Xevel/usb2ax/pc_software/usb2ax_updater/usb2ax_updater.jpg

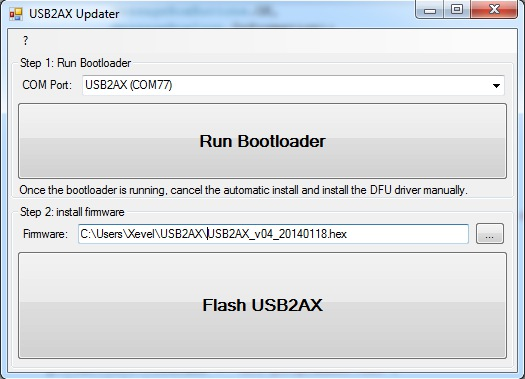
pc_software/usb2ax_updater/usb2ax_updater.jpg
