Xevel/usb2ax/(threads)

Thread 1 (2016-09-08):

Can send use a sync_write

metropt, 2016-09-08:
I'm trying to write the goal pos to two motors however I need to send the following packet two times to make it work whatever id I choose first only the first motor on the chain is activated :sa:

```
            dxl_set_txpacket_id( 254 );
            dxl_set_txpacket_length( 10 ); //Length (L+1) X N + 4   (L: Data Length per RX-64, N: the number of RX-64s)
            dxl_set_txpacket_instruction( 131 );
            dxl_set_txpacket_parameter( 0, GOAL_POSITION_L );
            dxl_set_txpacket_parameter( 1, 2 );
            dxl_set_txpacket_parameter( 2, 2 );
            dxl_set_txpacket_parameter( 3, dxl_get_lowbyte( goal_pos_[0] ) );
            dxl_set_txpacket_parameter( 4, dxl_get_highbyte( goal_pos_[0] ) );
            dxl_set_txpacket_parameter( 5, 1 );
            dxl_set_txpacket_parameter( 6, dxl_get_lowbyte( goal_pos_[0] ) );
            dxl_set_txpacket_parameter( 7, dxl_get_highbyte( goal_pos_[0] ) );
```

Xevel, 2016-09-08:
Hi!
I'm not really sure what is going wrong here, are you sure the rest of the setup is OK?
Can you move the second servo with a write_data packet?

And also, if you are using the version of the lib I have on this repo, why don't you simply use the sync_write functions instead of building the packet yourself (less error-prone)?
[Sync_read example that also shows the sync_write](https://github.com/Xevel/usb2ax/blob/master/pc_software/usb2ax_DynamixelSDK/DynamixelSDK_sync/example/win32/visual%20c%2B%2B/SyncRead/SyncRead.cpp)

metropt, 2016-09-13:
Hello,

I tried the sync_write from you lib and it works well however now I'm getting problems with sync_read. I got a lot incorrect status packet:

`[ INFO] [1473761250.694434838]: 1=559
[ INFO] [1473761250.694477383]: 2=300

[ INFO] [1473761250.714561671]: 1=559
[ INFO] [1473761250.714606049]: 2=300

[ INFO] [1473761250.734441294]: 1=559
[ INFO] [1473761250.734487448]: 2=300

[ INFO] [1473761250.754562067]: 1=559
[ INFO] [1473761250.754605699]: 2=300

[ INFO] [1473761250.774435077]: 1=559
[ INFO] [1473761250.774478255]: 2=300

[ INFO] [1473761250.794558795]: 1=559
[ INFO] [1473761250.794600594]: 2=300

[ INFO] [1473761250.814441386]: 1=559
[ INFO] [1473761250.814486643]: 2=300

[ INFO] [1473761250.834686948]: 1=559
[ INFO] [1473761250.834731101]: 2=300

[ INFO] [1473761250.854559114]: 1=559
[ INFO] [1473761250.854600383]: 2=300

[ INFO] [1473761250.874564379]: 1=559
[ INFO] [1473761250.874611105]: 2=300

[ INFO] [1473761250.894564307]: 1=559
[ INFO] [1473761250.894609096]: 2=300

[ INFO] [1473761250.914686532]: 1=559
[ INFO] [1473761250.914726632]: 2=300

[ INFO] [1473761250.934559446]: 1=559
[ INFO] [1473761250.934602664]: 2=300

[ INFO] [1473761250.954562389]: 1=559
[ INFO] [1473761250.954605527]: 2=300

[ INFO] [1473761250.974561927]: 1=559
[ INFO] [1473761250.974605576]: 2=300

[ INFO] [1473761250.994559181]: 1=559
[ INFO] [1473761250.994600444]: 2=300

[ INFO] [1473761251.014439385]: 1=559
[ INFO] [1473761251.014485850]: 2=300

[ INFO] [1473761251.034558490]: 1=559
[ INFO] [1473761251.034600241]: 2=300

[ INFO] [1473761251.054563809]: 1=559
[ INFO] [1473761251.054608194]: 2=300

[ INFO] [1473761251.074564510]: 1=559
[ INFO] [1473761251.074611699]: 2=300

[ INFO] [1473761251.094436413]: 1=559
[ INFO] [1473761251.094479037]: 2=300

[ INFO] [1473761251.114559450]: 1=559
[ INFO] [1473761251.114601346]: 2=300

[ INFO] [1473761251.134558628]: 1=559
[ INFO] [1473761251.134599705]: 2=300

[ INFO] [1473761251.154616545]: 1=559
[ INFO] [1473761251.154661347]: 2=300

[ INFO] [1473761251.174593964]: 1=559
[ INFO] [1473761251.174654738]: 2=300

[ INFO] [1473761251.194599484]: 1=559
[ INFO] [1473761251.194650821]: 2=300

[ INFO] [1473761251.214469942]: 1=559
[ INFO] [1473761251.214513722]: 2=300

[ INFO] [1473761251.234599732]: 1=559
[ INFO] [1473761251.234645621]: 2=300

[ INFO] [1473761251.254598864]: 1=559
[ INFO] [1473761251.254644714]: 2=300

[ INFO] [1473761251.274591423]: 1=559
[ INFO] [1473761251.274632121]: 2=300

[ INFO] [1473761251.294593208]: 1=559
[ INFO] [1473761251.294635295]: 2=300

[ INFO] [1473761251.314467278]: 1=559
[ INFO] [1473761251.314507783]: 2=65535

[ INFO] [1473761251.334477456]: 1=559
[ INFO] [1473761251.334546297]: 2=300

[ INFO] [1473761251.354603917]: 1=559
[ INFO] [1473761251.354650028]: 2=65535

[ INFO] [1473761251.374588057]: 1=559
[ INFO] [1473761251.374633864]: 2=300

[ INFO] [1473761251.394576031]: 1=559
[ INFO] [1473761251.394620455]: 2=300

[ INFO] [1473761251.414601759]: 1=559
[ INFO] [1473761251.414647350]: 2=300

[ INFO] [1473761251.434592444]: 1=559
[ INFO] [1473761251.434632395]: 2=65535

[ INFO] [1473761251.454596015]: 1=559
[ INFO] [1473761251.454638298]: 2=300

[ INFO] [1473761251.474575276]: 1=559
[ INFO] [1473761251.474634469]: 2=65535

[ INFO] [1473761251.494566517]: 1=559
[ INFO] [1473761251.494618563]: 2=300

[ INFO] [1473761251.514566383]: 1=559
[ INFO] [1473761251.514618284]: 2=65535

[ INFO] [1473761251.534442431]: 1=559
[ INFO] [1473761251.534496357]: 2=301

[ INFO] [1473761251.554566425]: 1=559
[ INFO] [1473761251.554617983]: 2=65535

[ INFO] [1473761251.574567989]: 1=559
[ INFO] [1473761251.574622302]: 2=300

[ INFO] [1473761251.594581237]: 1=559
[ INFO] [1473761251.594637699]: 2=65535

[ INFO] [1473761251.614568112]: 1=559
[ INFO] [1473761251.614619575]: 2=300

[ INFO] [1473761251.634567871]: 1=559
[ INFO] [1473761251.634619959]: 2=65535

[ INFO] [1473761251.654570137]: 1=559
[ INFO] [1473761251.654623414]: 2=300

[ INFO] [1473761251.674563754]: 1=559
[ INFO] [1473761251.674613520]: 2=65535

[ INFO] [1473761251.694447221]: 1=559
[ INFO] [1473761251.694503734]: 2=300

[ INFO] [1473761251.714566023]: 1=559
[ INFO] [1473761251.714616845]: 2=65535

COMM_RXCORRUPT: Incorrect status packet!

[ INFO] [1473761251.754587500]: 1=559
[ INFO] [1473761251.754662450]: 2=65535

COMM_RXCORRUPT: Incorrect status packet!

[ INFO] [1473761251.794586438]: 1=559
[ INFO] [1473761251.794654394]: 2=65535

^CCOMM_RXCORRUPT: Incorrect status packet!

[ INFO] [1473761251.834603526]: 1=559
[ INFO] [1473761251.834656415]: 2=65535

COMM_RXCORRUPT: Incorrect status packet!

[wiigo_active_camera-1] killing on exit
[ INFO] [1473761251.874591459]: 1=559
[ INFO] [1473761251.874650561]: 2=300

COMM_RXCORRUPT: Incorrect status packet!
`

Any idea?

My setup:
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

Xevel, 2016-09-13:
Hmm, not sure, but have you set Reponse Delay to zero on all servos? the timeout in the sync_read code is pretty short, could have something to do with it...

Thread 4 (2017-07-26):

Handle dynamixel protocol 2 ...

tho-, 2017-07-26:
Hi,

I flashed the latest firmware available in the repo ( USB2AX_v05RC0.hex ) on a USB2AX v3.2a.
I'm communicating with MX and XM motors that talk protocol 2.

The problem is that all messages, that start by construction with 0xff 0xff 0xfd 0x0, are interpreted by the USB2AX as (bad) messages for itself with a 0 length. So it passes the message to the MX motor (ok), but then replies on the usb with a protocol 1 error message which does not make sense here.

Would there be a way to disable this interpretation of dynamixel protocol? Or recognize protol 2 messages (starting with 0xff ff fd 00) as such and not reply with an error?

Xevel, 2017-07-26:
Hi,

Could you put the old (v04) firmware back please?
I'll need some time to get to this, can't do it right away.

You cab download it here: http://www.xevelabs.com/doku.php?id=product:usb2ax:firmware

Best
Nicolas

tho-, 2017-07-26:
On Wednesday 26 Jul 2017, at 18:32, Nicolas SAUGNIER wrote:
> Could you put the old (v04) firmware back please?
> I'll need some time to get to this, can't do it right away.

No, the old firmware is not usable for me. I need to transmit large
messages, (around 128 bytes x 2 motors or even 3), and I had a lot of
message corruption with the v04 firmware. (while the exact same setup
runs fine with the USBtoDynamixel device).

That's why I upgraded. The increased buffer size in the latest version
helps a lot. (although I still experience a few message corruption
from time to time).

I understand perfectly that you cannot work on this immediately.
The short-term fix I have in mind is just a couple of lines long. If I
suggest a patch, maybe you could just apply it and build a new image
in a few minutes?

I wish I could compile the code myself. But when I tried, I could not
produce a useable software. I don't have AVR Studio, so I compiled
everything manually with avr-gcc (on linux), but for some reason the
hex file I obtain is about ~40kB large (instead of the ~17kB file in
the repository) and hangs the device when it is flashed. I tried to
put the same avr-gcc options as in the .cproj file (-Os, -gc-sections,
etc.), but I could not understand why it's not working yet.

Xevel, 2017-07-26:
Hmm, seems like there is definitely a big problem on my side, sorry about that.

If you have a fix I can compile it for you, sure.

For your problem with avr-gcc, seems to me like link-time issues, where some "standard" libs are automatically added by AVR studio.

Just out of curiosity, what is your application where you need to send messages that long - it you can share ?

tho-, 2017-07-26:
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

I attach a diff which should do the trick. (untested, however).
Comments in the code should explain what I'm doing, but if you have
any doubt we can discuss about it.

> For your problem with avr-gcc, seems to me like link-time issues,
> where some "standard" libs are automatically added by AVR studio.

If AVR studio ever displays the actual compile command line, I'd be
curious to compare with what I'm doing.

> Just out of curiosity, what is your application where you need to
> send messages that long - it you can share ?

To be exact, I need to receive such messages, not to send them. When
configuring the motors, I use a protocol 2.0 SYNC_READ message to
retrieve a great part of the control table of all connected devices.

It's true that I could split this into several smaller messages. It's
doable if nothing else works, but since I saw the commits here, fixing
the buffer issue, I wanted to give it a try first (and I was not sure
until after trying that the message size was the issue).

The other issue that I'm trying to address in the attached patch seems
to be only remaining one, so I'd say it's worth trying to get rid of
it :) But if you think that v04 would work better with small
protocol 2.0 messages, then I could try to do that instead.

My code is freely available, although of little interest to share
because it uses a custom integration framework (also free, but complex
to get into). All this is part of research projects using multirotor
drones equipped with manipulator arms.
You can get an idea there:
http://homepages.laas.fr/afranchi/robotics/?q=node/416
The actual motor code can be seen here:
https://git.openrobots.org/projects/dynamixel-genom3/repository

diff --git firmware/lufa_usb2ax/USB2AX.c firmware/lufa_usb2ax/USB2AX.c
index 8692398..22f8e40 100644
--- firmware/lufa_usb2ax/USB2AX.c
+++ firmware/lufa_usb2ax/USB2AX.c
@@ -293,8 +293,13 @@ void process_incoming_USB_data(void){
                    
                 case AX_SEARCH_LENGTH:
                     rxbyte[rxbyte_count++] = CDC_Device_ReceiveByte(&USB2AX_CDC_Interface);
-                    if (rxbyte[PACKET_ID] == AX_ID_DEVICE || rxbyte[PACKET_ID] == AX_ID_BROADCAST ){
-                        if (rxbyte[PACKET_LENGTH] > 1 && rxbyte[PACKET_LENGTH] < (AX_SYNC_READ_MAX_DEVICES + 4)){  // reject message if too short or too big for rxbyte buffer
+                    if (rxbyte[PACKET_ID] == 0xFD && (rxbyte[PACKET_LENGTH] == 0 || rxbyte[PACKET_LENGTH] == 0xFD)) {
+                        // We've seen 0xFF 0xFF 0xFD 0x0 or 0xFF 0xFF 0xFD 0xFD
+                        // Both are protocol 2.0 messages (header or "byte stuffing")
+                        // Let this pass - both are invalid for us anyway
+                        cleanup_input_parser();
+                    } else if (rxbyte[PACKET_ID] == AX_ID_DEVICE || rxbyte[PACKET_ID] == AX_ID_BROADCAST ){
+                         if (rxbyte[PACKET_LENGTH] > 1 && rxbyte[PACKET_LENGTH] < (AX_SYNC_READ_MAX_DEVICES + 4)){  // reject message if too short or too big for rxbyte buffer
                             ax_state = AX_SEARCH_COMMAND;
                             receive_timer = 0;
                         } else {

Xevel, 2017-07-27:
Hi,

So I had a better look... and sure enough stuff is all f**** up when using DXL2.0 with the latest version of Dynamixel Wizard, and I guess the fact that it worked in other cases was just down to implementation details (a lib that would match 1-1 packets would never receive the answer to sync_read_2.0, whereas one that processes packet as they come might...).

So I applied your patch, and things look better now.
I uploaded the binary of v05 RC1, please tell me if it fixed your problem.
Also so far I credited you with your github handle, let me know if you prefer your real name.

Find here the full output of the build : https://pastebin.com/QhbBByLH

And that's pretty cool stuff you're working on :D Have fun!

tho-, 2017-07-27:
On Wednesday 26 Jul 2017, at 22:47, Nicolas SAUGNIER wrote:
> So I applied your patch, and things look better now.  I uploaded the
> binary of v05 RC1, please tell me if it fixed your problem.

Yes. I just did a quick test, but it already shows much better
results.
Thanks Nicolas for the promptness!

> Also so far I credited you with your github handle, let me know if
> you prefer your real name.

I'm Anthony Mallet outside github, which might be a more reliable
name than my github handle :) But don't bother with this, I don't care
so much :)

> Find here the full output of the build :
> https://pastebin.com/QhbBByLH

Thanks, I will check. If I later manage to build it for linux, I might
submit a Makefile or something, to add in the repo, if you like.

Closed 2017-07-27.
