Xevel/usb2ax/hardware/usb2ax_v3.2.brd

## EAGLE design hardware/usb2ax_v3.2.brd (2016-04-06, an earlier design)

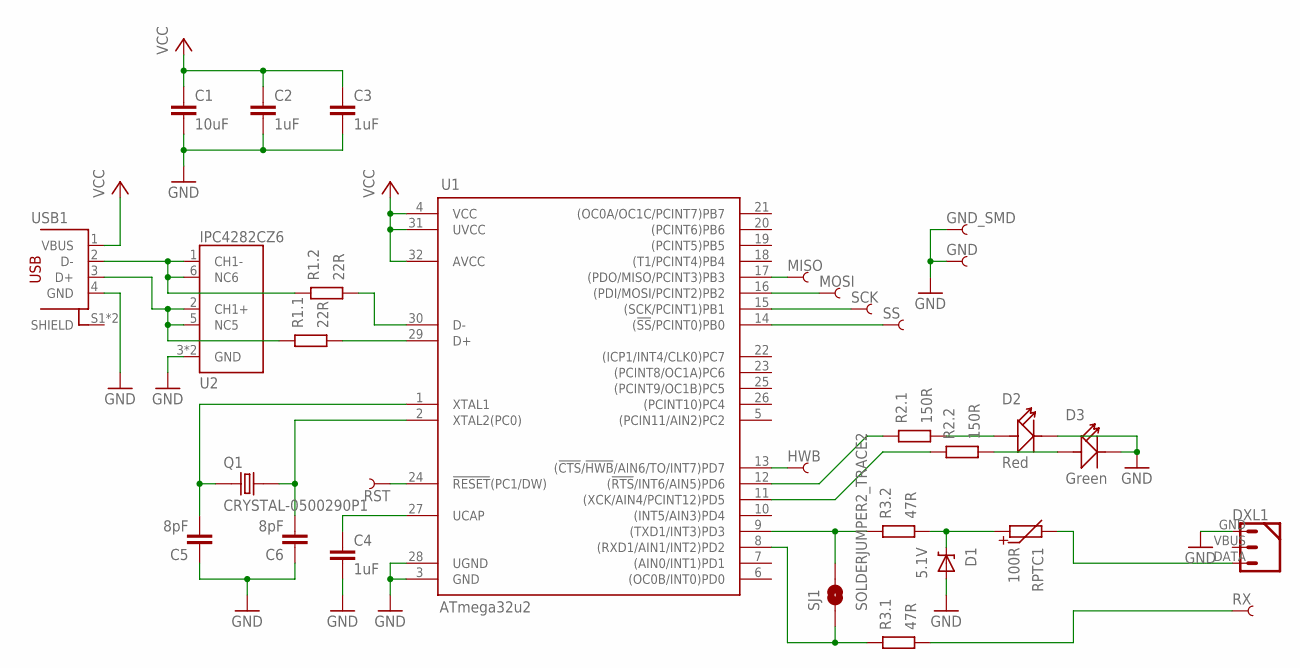
[picture p2: schematic usb2ax_v3.2.sch]

Parts:
C1: 10uF; 0805_L
C2, C3, C4: 1uF; 0402_N
C5, C6: 8pF; 0402_N
D1: 5.1V; SOD-923_N
D2: Red; LED0603
D3: Green; LED0603
DXL1: DYNAMIXEL_3POS; DYMANIXEL_3POS_RIGHT
GND: PIN_SMD_2X2.5
GND_SMD: PIN_SMD_2X2.5
HWB: PIN_SMD_2X2.5
MISO: PIN_SMD_2X2.5
MOSI: PIN_SMD_2X2.5
Q1: CRYSTAL-0500290P1; 2P-SMD-5.0X3.2
R1: 22R; ARRAY_0402_65P_2_N
R2: 150R; ARRAY_0402_65P_2_N
R3: 47R; ARRAY_0402_65P_2_N
RPTC1: 100R; 0603_N
RST: PIN_SMD_2X2.5
RX: PIN_THT_0.8; PIN_0.8
SCK: PIN_SMD_2X2.5
SJ1: SOLDERJUMPER2_TRACE2; SJ_2S-TRACE2
SS: PIN_SMD_2X2.5
U1: ATmega32u2; QFN-32_50P_L_MOD
U2: IPC4282CZ6; XSON6_N
USB1: USB-STANDARD-PLUG_A_THT; USB-A-THT

Connections:
GND: C1.2, C2.2, C3.2, C4.2, C5.1, C6.1, D1.A, D2.-, D3.-, DXL1.GND (1), GND.PIN, GND_SMD.PIN, U1.3 (GND), U1.28 (UGND), U2.3 (GND), U2.4 (GND), USB1.4 (GND)
HWB: HWB.PIN, U1.13 ((!CTS!/!HWB!/AIN6/TO/INT7)PD7)
unnamed: R3.4 (2), SJ1.2, U1.9 ((TXD1/INT3)PD3)
unnamed: R3.3 (2), SJ1.1, U1.8 ((RXD1/AIN1/INT2)PD2)
unnamed: C4.1, U1.27 (UCAP)
unnamed: D1.C, R3.1, RPTC1.1
unnamed: R2.4 (2), U1.11 ((XCK/AIN4/PCINT12)PD5)
unnamed: DXL1.DATA (3), RPTC1.2
unnamed: C6.2, Q1.2, U1.2 (XTAL2(PC0))
unnamed: C5.2, Q1.1, U1.1 (XTAL1)
unnamed: R1.1, U1.30 (D-)
unnamed: R1.2 (1), U1.29 (D+)
unnamed: R1.4 (2), U2.1 (CH1-), U2.6 (NC6), USB1.2 (D-)
unnamed: R1.3 (2), U2.2 (CH1+), U2.5 (NC5), USB1.3 (D+)
unnamed: D2.+, R2.2 (1)
unnamed: D3.+, R2.1
unnamed: R2.3 (2), U1.12 ((!RTS!/INT6/AIN5)PD6)
unnamed: R3.2 (1), RX.PIN
unnamed: MISO.PIN, U1.17 ((PDO/MISO/PCINT3)PB3)
unnamed: MOSI.PIN, U1.16 ((PDI/MOSI/PCINT2)PB2)
unnamed: SCK.PIN, U1.15 ((SCK/PCINT1)PB1)
unnamed: SS.PIN, U1.14 ((!SS!/PCINT0)PB0)
RST: RST.PIN, U1.24 (!RESET!(PC1/DW))
VCC: C1.1, C2.1, C3.1, U1.4 (VCC), U1.31 (UVCC), U1.32 (AVCC), USB1.1 (VBUS)

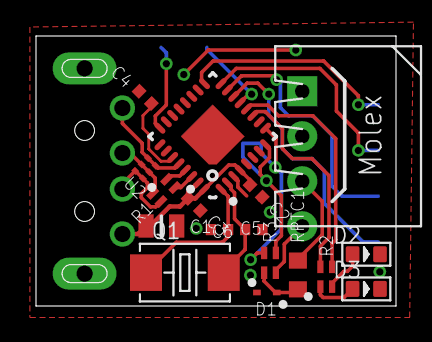
[picture p3: board usb2ax_v3.2.brd from above]

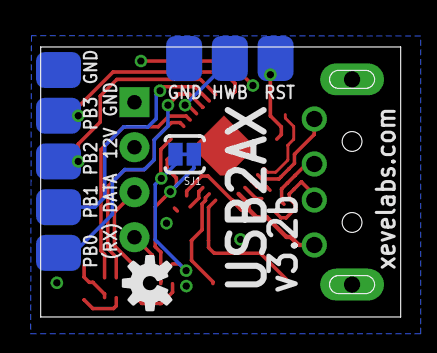
[picture p4: board usb2ax_v3.2.brd from below]

Board: 2 copper layers, 20.0 x 15.0 mm, 29 parts (10 on the bottom side), 24 nets.

Other parts of the board:
U$1: OSHW-LOGO-S
