Xevel/usb2ax/hardware/usb2ax_v4.0.brd

## EAGLE design hardware/usb2ax_v4.0.brd (2014-12-30)

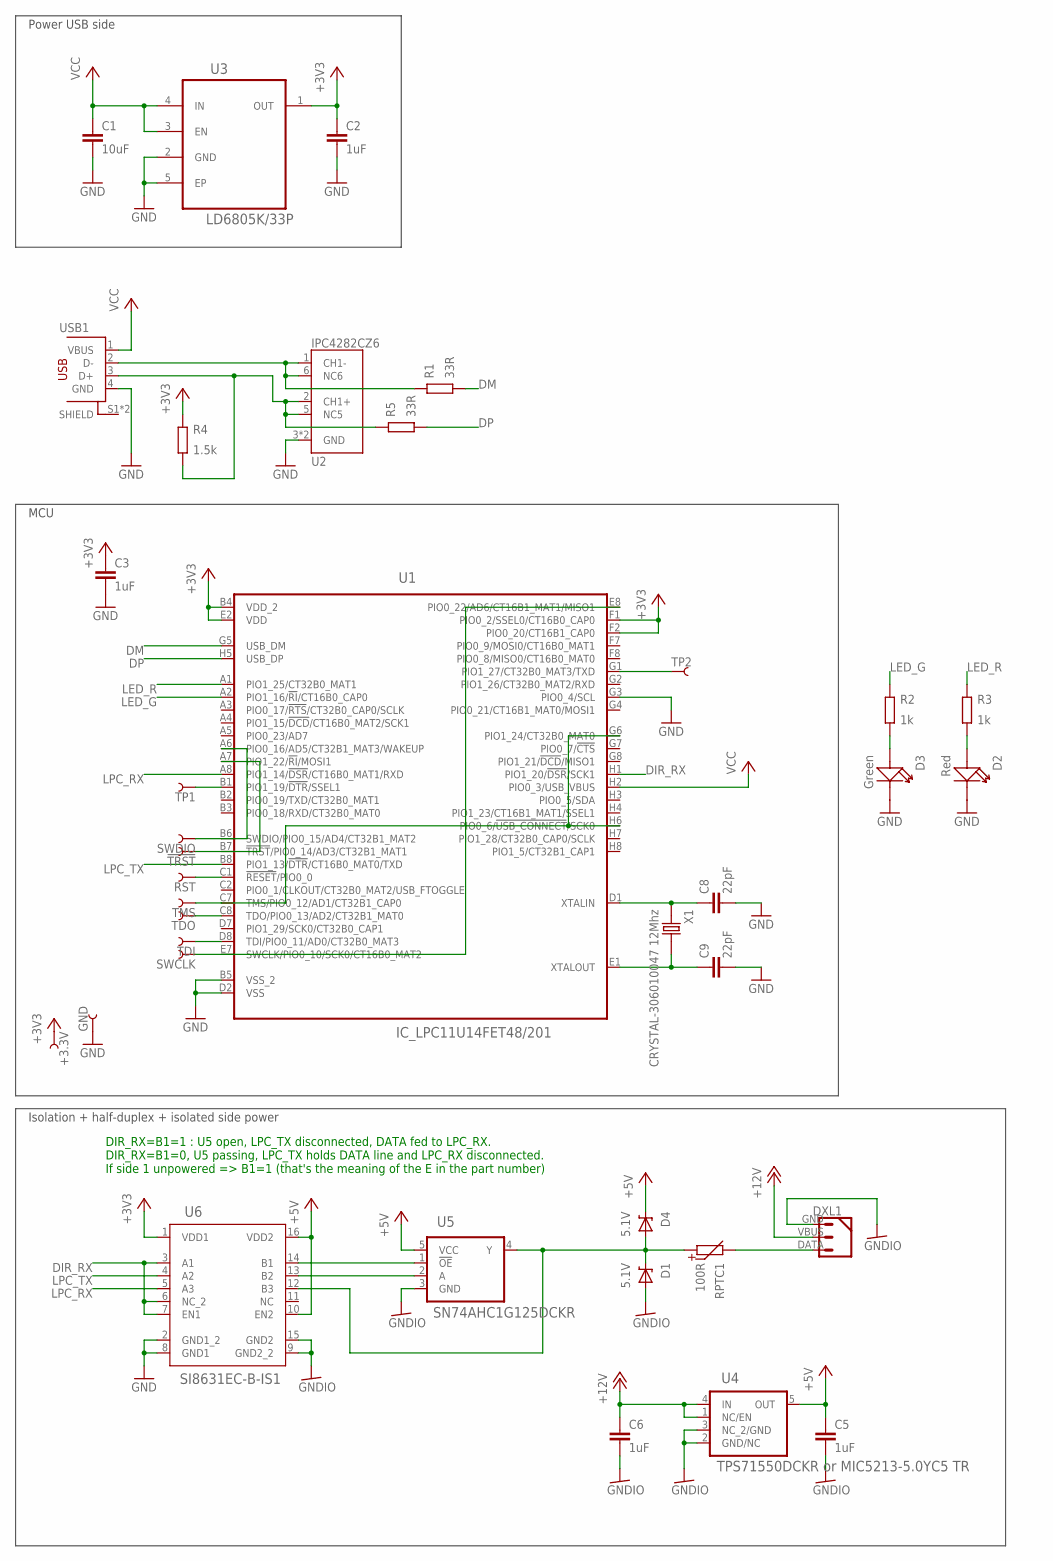
[picture p5: schematic usb2ax_v4.0.sch]

Parts:
!TRST: PIN_SMD_1X1
+3.3V: PIN_SMD_1X1
C1: 10uF; 0805_L
C2, C3, C5, C6: 1uF; 0402_N
C8, C9: 22pF; 0402_N
D1, D4: 5.1V; SOD-923_N
D2: Red; LED0603
D3: Green; LED0603
DXL1: DYNAMIXEL_3POS-R; DYNAMIXEL_3POS_RIGHT
GND: PIN_SMD_1X1
R1, R5: 33R; 0201_N
R2, R3: 1k; 0201_N
R4: 1.5k; 0201_N
RPTC1: 100R; 0603_N
RST: PIN_SMD_1X1
SWCLK: PIN_SMD_1X1
SWDIO: PIN_SMD_1X1
TDI: PIN_SMD_1X1
TDO: PIN_SMD_1X1
TMS: PIN_SMD_1X1
TP1, TP2: PIN_SMD_1X1
U1: IC_LPC11U14FET48/201; BGA48C50P8X8_460X460X110
U2: IPC4282CZ6; XSON6_N
U3: LD6805K/33P; NXP_LD6805
U4: TPS71550DCKR or MIC5213-5.0YC5 TR; SOT65P210X110-5N
U5: SN74AHC1G125DCKR; SOT65P210X110-5N
U6: SI8631EC-B-IS1; SOIC-16
USB1: USB-STANDARD-PLUG_A_THT; USB-A-THT
X1: CRYSTAL-306010047 12Mhz; 2P-SMD-5.0X3.2

Connections:
!TRST: !TRST.P$1, U1.A7 (PIO1_22/!RI!/MOSI1), U1.B7 (!TRST!/PIO0_14/AD3/CT32B1_MAT1)
+3V3: +3.3V.P$1, C2.1, C3.1, R4.2, U1.B4 (VDD_2), U1.E2 (VDD), U1.F1 (PIO0_2/SSEL0/CT16B0_CAP0), U1.F2 (PIO0_20/CT16B1_CAP0), U3.1 (OUT), U6.1 (VDD1)
+5V: C5.1, D4.C, U4.5 (OUT), U5.5 (VCC), U6.10 (EN2), U6.16 (VDD2)
+12V: C6.1, DXL1.VBUS (2), U4.1 (NC/EN), U4.4 (IN)
DIR_RX: U1.H1 (PIO1_20/!DSR!/SCK1), U6.3 (A1), U6.6 (NC_2), U6.7 (EN1)
DM: R1.1, U1.G5 (USB_DM)
DP: R5.1, U1.H5 (USB_DP)
GND: C1.2, C2.2, C3.2, C8.2, C9.2, D2.-, D3.-, GND.P$1, U1.B5 (VSS_2), U1.D2 (VSS), U1.G3 (PIO0_4/SCL), U2.3 (GND), U2.4 (GND), U3.2 (GND), U3.5 (EP), U6.2 (GND1_2), U6.8 (GND1), USB1.4 (GND)
GNDIO: C5.2, C6.2, D1.A, DXL1.GND (1), U4.2 (GND/NC), U4.3 (NC_2/GND), U5.3 (GND), U6.9 (GND2_2), U6.15 (GND2)
LED_G: R2.2, U1.A2 (PIO1_16/!RI!/CT16B0_CAP0)
LED_R: R3.2, U1.A1 (PIO1_25/CT32B0_MAT1)
LPC_RX: U1.A8 (PIO1_14/!DSR!/CT16B0_MAT1/RXD), U6.5 (A3)
LPC_TX: U1.B8 (PIO1_13/!DTR!/CT16B0_MAT0/TXD), U6.4 (A2)
unnamed: TP1.P$1, U1.B1 (PIO1_19/!DTR!/SSEL1)
unnamed: D3.+, R2.1
unnamed: U5.2 (A), U6.13 (B2)
unnamed: D1.C, D4.A, RPTC1.1, U5.4 (Y), U6.12 (B3)
unnamed: TP2.P$1, U1.G1 (PIO1_27/CT32B0_MAT3/TXD)
unnamed: DXL1.DATA (3), RPTC1.2
unnamed: C9.1, U1.E1 (XTALOUT), X1.2
unnamed: C8.1, U1.D1 (XTALIN), X1.1
unnamed: D2.+, R3.1
unnamed: R1.2, U2.1 (CH1-), U2.6 (NC6), USB1.2 (D-)
unnamed: R4.1, R5.2, U2.2 (CH1+), U2.5 (NC5), USB1.3 (D+)
unnamed: U5.1 (!OE), U6.14 (B1)
RST: RST.P$1, U1.C1 (!RESET!/PIO0_0)
SWCLK: SWCLK.P$1, U1.E7 (SWCLK/PIO0_10/SCK0/CT16B0_MAT2), U1.E8 (PIO0_22/AD6/CT16B1_MAT1/MISO1)
SWDIO: SWDIO.P$1, U1.A6 (PIO0_16/AD5/CT32B1_MAT3/WAKEUP), U1.B6 (SWDIO/PIO0_15/AD4/CT32B1_MAT2)
TDI: TDI.P$1, U1.D8 (TDI/PIO0_11/AD0/CT32B0_MAT3)
TDO: TDO.P$1, U1.C8 (TDO/PIO0_13/AD2/CT32B1_MAT0)
TMS: TMS.P$1, U1.C7 (TMS/PIO0_12/AD1/CT32B1_CAP0), U1.G6 (PIO1_24/CT32B0_MAT0), U1.H6 (PIO0_6/!USB_CONNECT!/SCK0)
VCC: C1.1, U1.H2 (PIO0_3/USB_VBUS), U3.3 (EN), U3.4 (IN), USB1.1 (VBUS)

Notes on the sheet:
DIR_RX=B1=1 : U5 open, LPC_TX disconnected, DATA fed to LPC_RX. DIR_RX=B1=0, U5 passing, LPC_TX holds DATA line and LPC_RX disconnected. If side 1 unpowered => B1=1 (that's the meaning of the E in the part number)
Isolation + half-duplex + isolated side power
MCU
Power USB side

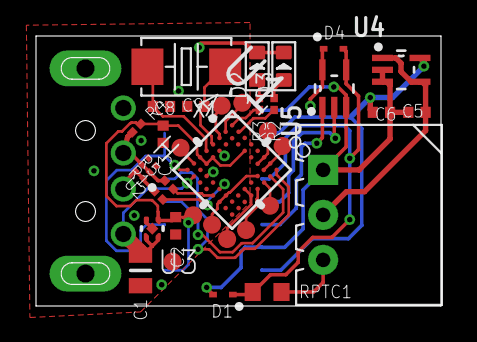
[picture p6: board usb2ax_v4.0.brd from above]

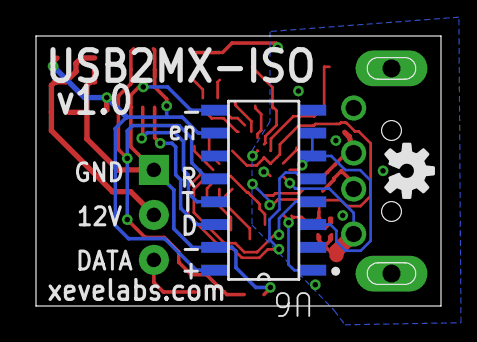
[picture p7: board usb2ax_v4.0.brd from below]

Board: 2 copper layers, 22.5 x 15.0 mm, 38 parts (2 on the bottom side), 32 nets.

Other parts of the board:
U$1: OSHW-LOGO-S
