Xevel/usb2ax/firmware/lufa_usb2ax/USB2AX.c

/* ****************************************************************************
Copyright (C) 2014 Nicolas Saugnier (nicolas.saugnier [at] esial {dot} net),
                   Richard Ibbotson (richard.ibbotson [at] btinternet {dot} com)
					   
			  2017 Contributions by Seed Robotics EU (seed [at] seedrobotics {dot} com )

Date   : 2012/05/06

Based on :
    - USBtoSerial project in the LUFA Library by Dean Camera (original file)
    - USB2AXSYNC by Richard Ibbotson (USB2AX optimizations, sync_read and Dynamixel communication)
    - arbotix_python ROS package and Arbotix Robocontroller firmware by Michael Ferguson (sync_read and part of the Dynamixel communication)

Original copyright notice : 
  Copyright 2013  Dean Camera (dean [at] fourwalledcubicle [dot] com)

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
  The author disclaims all warranties with regard to this
  software, including all implied warranties of merchantability
  and fitness.  In no event shall the author be liable for any
  special, indirect or consequential damages or any damages
  whatsoever resulting from loss of use, data or profits, whether
  in an action of contract, negligence or other tortious action,
  arising out of or in connection with the use or performance of
  this software.
*******************************************************************************/

/** \file
 *
 *  Main source file for the USB2AX project. This file contains the main tasks of
 *  the application and is responsible for the initial application hardware configuration.
 *  The USB2AX sends data from the USB to the serial port and sends back data coming
 *  from the serial port to the USB. It can also understand some instructions to perform
 *  higher-level task, like reading data from multiple servos by itself.
 */

#include "USB2AX.h"
#include "AX.h"
#include "reset.h"
#include <util/delay.h>
#include "eeprom.h"
#include "debug.h"

/*TODO list for the firmware:
- instead of arbitrarily limiting the number of bytes and of servos in sync_read, limit bytes*servos instead...
- there's been reports of the LED turning off when the computer goes to sleep and not turning on again when woke up...
- try to fill the IN bank as the bytes arrives instead of at the last moment, see if there is something to be gained...
- proper Doxygen doc instead of a bunch of random comments here and there
- rework the timers to have something (maybe)faster and less ugly
Done:
- make the timeout lengths R/W parameters. Maybe set a minimum to avoid blocking the input...
- baud rate: use frequency doubling if needed (example : 57200 should become 57142, not around 58823)
*/

#define USE_RS485   (0)  // for use with a RS485 transceiver, /RE and DE connected to PB1 (SN75176 or equivalent)


/** LUFA CDC Class driver interface configuration and state information. */
USB_ClassInfo_CDC_Device_t USB2AX_CDC_Interface =
    {
        .Config =
        {
            .ControlInterfaceNumber         = 0,
            .DataINEndpoint                 =
            {
                .Address                = CDC_TX_EPADDR,
                .Size                   = CDC_TXRX_EPSIZE,
                .Banks                  = 1,
            },
            .DataOUTEndpoint                =
            {
                .Address                = CDC_RX_EPADDR,
                .Size                   = CDC_TXRX_EPSIZE,
                .Banks                  = 1,
            },
            .NotificationEndpoint           =
            {
                .Address                = CDC_NOTIFICATION_EPADDR,
                .Size                   = CDC_NOTIFICATION_EPSIZE,
                .Banks                  = 1,
            },
        },
    };

// Sending data to USB
RingBuffer_t	ToUSB_Buffer;  // Circular buffer to hold data before it is sent to the host.
static uint8_t  ToUSB_Buffer_Data[254]; // Underlying data buffer for \ref ToUSB_Buffer, where the stored bytes are located.
										/* Seed Robotics 29-6-2017: increased size from 128 to 254;
										 * this should accommodate larger bursts of data on devices with longer control
										 * tables. Upon reviewing the memory usage reported by the compiler, it seems
										 * it is already at 60% when we set it to 254, meaning we should not increase this more for now.
										 * This works for Dynamixel 1 but for Dynamixel 2 protocol, length of packet
										 * is 2 bytes and the control tables for XM series and MX with Dynamixel 2
										 * have some particularities: full functionality in in the lower 255 bytes but extended Indirect
										 * address functionality (new in XM series) is in memory positions that go all the way up to
										 * 661; it is unlikely that one performs a read on the whole table since part of the data would be
										 * duplicated; However Dynamixel Wizard does this (reads the full table) and for this reason, 
										 * this buffer should be made much larger to cope with that (at least 512; ideal 1Kb) 
										 * to ensure we don't lose bytes in case of a USB latency
										 * issue that delays transmission to the host.
										 * Also if we make it > 255 bytes, we will need to change the RingBuffer_t structures to ints 
										 * instead of uint8s for indexes as they would be > 255
										 */
uint8_t needEmptyPacket = false; // flag used when an additional, empty packet needs to be sent to properly conclude an USB transfer

// Buffer used when diverting USART data for local processing
uint8_t	local_rx_buffer[AX_BUFFER_SIZE];
volatile uint8_t local_rx_buffer_count = 0;

// Pass through 
bool passthrough_mode = AX_PASSTHROUGH; // determines if data from the USART is passed to the USB or diverted for local processing

// Dynamixel packet parser stuff
// AX receive states
#define AX_SEARCH_FIRST_FF   0
#define AX_SEARCH_SECOND_FF  1
#define AX_SEARCH_ID         2
#define AX_SEARCH_LENGTH     3
#define AX_SEARCH_COMMAND    4
#define AX_SEARCH_RESET      5
#define AX_SEARCH_BOOTLOAD   6
#define AX_GET_PARAMETERS    7
#define AX_SEARCH_READ       8
#define AX_SEARCH_PING       9
#define AX_PASS_TO_SERVOS    10

uint8_t ax_state = AX_SEARCH_FIRST_FF; // current state of the Dynamixel packet parser state machine
uint16_t ax_checksum = 0;
uint8_t rxbyte[AX_SYNC_READ_MAX_DEVICES + 8]; // buffer where currently processed data are stored when looking for a Dynamixel packet, with enough space for longest possible sync read request
uint8_t rxbyte_count = 0;   // number of used bytes in rxbyte buffer


uint8_t needs_bootload = false; // In EVENT_CDC_Device_LineEncodingChanged, this flag is set when the baudrate is at a pre-defined value


// timeout
volatile uint8_t receive_timer = 0; // timer for Dynamixel packet reception from USB
volatile uint8_t    send_timer = 0; // timer for sending data to the PC
volatile uint8_t   usart_timer = 0; // timer for RX read timeout


int main(void){
    setup_hardware();
    
    axInit();
    init_debug();

    RingBuffer_InitBuffer(&ToUSB_Buffer, ToUSB_Buffer_Data, sizeof(ToUSB_Buffer_Data));
	LEDs_SetAllLEDs(LEDMASK_USB_NOTREADY);
    sei();

    // enable pull-up on TX and RX pin to prevent spurious signal.
    bitClear(DDRD,2);
    bitSet( PORTD,2);
    bitClear(DDRD,3);
    bitSet( PORTD,3);
    
    for (;;){
        while (USB_DeviceState != DEVICE_STATE_Configured); // wait for device to be configured
        
        // get bytes from USB
        process_incoming_USB_data();
        
        send_USB_data();
        
        USB_USBTask();
    }
}

void cdc_send_byte(uint8_t data){ // TODO inline ?
	// Careful when calling this outside of the RX ISR: we should NEVER call it when the RX ISR is enabled (risk of corruption of the buffer)
	// So the best way to do it, if it was needed to call it while RX interrupt is enabled, would be to disable it, call this, then re-enable it immediately... and hope no char was lost
	// BUT anyway it should never happen : it would just corrupt the datastream to have multiple sources writing to it at the same time... so this warning is useless. 
	RingBuffer_Insert(&ToUSB_Buffer, data);
	send_timer = 0;
}

void send_USB_data(void){
	// process outgoing USB data
	Endpoint_SelectEndpoint(CDC_TX_EPADDR); // select IN endpoint to restore its registers
	if ( Endpoint_IsINReady() ){ // if we can write on the outgoing data bank
		uint8_t BufferCount = RingBuffer_GetCount(&ToUSB_Buffer);
		
		if (BufferCount) {
			// if there are more bytes in the buffer than what can be put in the data bank OR there are a few bytes and they have been waiting for too long
			if ( BufferCount >= CDC_TXRX_EPSIZE || send_timer > regs[ADDR_SEND_TIMEOUT] ){
				send_timer = 0;
				
				// load the IN data bank until full or until we loaded all the bytes we know we have
				uint8_t nb_to_write = min(BufferCount, CDC_TXRX_EPSIZE );					
				while (nb_to_write--){
                	uint8_t Data = RingBuffer_Remove(&ToUSB_Buffer);
					Endpoint_Write_8(Data);
				}
				
				// if the bank is full (== we can't write to it anymore), we might need an empty packet after this one
				needEmptyPacket = ! Endpoint_IsReadWriteAllowed();
				
				Endpoint_ClearIN(); // allow the hardware to send the content of the bank
			}
		} else if (needEmptyPacket) {
			// send an empty packet to end the transfer
			needEmptyPacket = false;
			Endpoint_ClearIN(); // allow the hardware to send the content of the bank
		}
		
	}
}

void cleanup_input_parser(void){
    // if the last byte read is not what it's expected to be, but is a 0xFF, it could be the first 0xFF of an incoming command
    if (rxbyte[rxbyte_count-1] == 0xFF){
		// we trade the latest 0xFF received against the first one that is necessarily in the first position of the buffer
        pass_bytes(rxbyte_count-1); // pass the discarded data, except the last 0xFF
        ax_state = AX_SEARCH_SECOND_FF;
        rxbyte_count = 1; // keep the first 0xFF in the buffer
		receive_timer = 0;
    } else {
        pass_bytes(rxbyte_count);
        ax_state = AX_SEARCH_FIRST_FF;
    }
}


#define PACKET_FIRST_0XFF  0
#define PACKET_SECOND_0XFF 1
#define PACKET_ID          2
#define PACKET_LENGTH      3
#define PACKET_INSTRUCTION 4
#define SYNC_READ_START_ADDR  5
#define SYNC_READ_LENGTH  6

void process_incoming_USB_data(void){
	uint8_t USB_nb_received = CDC_Device_BytesReceived (&USB2AX_CDC_Interface);
	
	if (USB_nb_received>0){
        for( uint8_t i = 0; i < USB_nb_received ; i++ ){

            //up2;dw2;
            //for(uint8_t dbg_i = 0; dbg_i<ax_state; dbg_i++){
              //up2;dw2;
            //}
            
            switch (ax_state){
                case AX_SEARCH_FIRST_FF:
                    rxbyte[PACKET_FIRST_0XFF] = CDC_Device_ReceiveByte(&USB2AX_CDC_Interface);
                    if (rxbyte[PACKET_FIRST_0XFF] == 0xFF){
                        //up2;dw2;
                        ax_state = AX_SEARCH_SECOND_FF;
                        rxbyte_count = 1;
                        receive_timer = 0;
                    } else {
                        setTX();
                        serial_write(rxbyte[0]);
                    }
                    break;
                            
                case AX_SEARCH_SECOND_FF:
                    rxbyte[rxbyte_count++] = CDC_Device_ReceiveByte(&USB2AX_CDC_Interface);
                    if (rxbyte[PACKET_SECOND_0XFF] == 0xFF){
                        ax_state = AX_SEARCH_ID;
                        receive_timer = 0;
                    } else {
                        cleanup_input_parser();
                    }
                    break;
                            
                case AX_SEARCH_ID:
                    rxbyte[rxbyte_count++] = CDC_Device_ReceiveByte(&USB2AX_CDC_Interface);
                    if (rxbyte[PACKET_ID] == 0xFF){ // we've seen 3 consecutive 0xFF
						rxbyte_count--;
						pass_bytes(1); // let a 0xFF pass
					    receive_timer = 0;
					} else {
                        ax_state = AX_SEARCH_LENGTH;
                        receive_timer = 0;
                    }
                    break;
                            
                case AX_SEARCH_LENGTH:
                    rxbyte[rxbyte_count++] = CDC_Device_ReceiveByte(&USB2AX_CDC_Interface);
                    if (rxbyte[PACKET_ID] == AX_ID_DEVICE && (rxbyte[PACKET_LENGTH] == 0 || rxbyte[PACKET_LENGTH] == 0xFD)) {
                        // Fix by Tho-, 2017/07/27
                        // We've seen 0xFF 0xFF 0xFD 0x0 or 0xFF 0xFF 0xFD 0xFD
                        // Both are protocol 2.0 messages (header or "byte stuffing")
                        // Let this pass - both are invalid for us anyway
                        cleanup_input_parser();
                    } else if (rxbyte[PACKET_ID] == AX_ID_DEVICE || rxbyte[PACKET_ID] == AX_ID_BROADCAST ){
                        if (rxbyte[PACKET_LENGTH] > 1 && rxbyte[PACKET_LENGTH] < (AX_SYNC_READ_MAX_DEVICES + 4)){  // reject message if too short or too big for rxbyte buffer
                            ax_state = AX_SEARCH_COMMAND;
                            receive_timer = 0;
                        } else {
                            axStatusPacket(AX_ERROR_RANGE, NULL, 0);
                            cleanup_input_parser();
                        }
                    } else {
                    pass_bytes(rxbyte_count);
                        ax_state = AX_PASS_TO_SERVOS;
                        receive_timer = 0;
                    }
                    break;
                            
                case AX_SEARCH_COMMAND:
                    rxbyte[rxbyte_count++] = CDC_Device_ReceiveByte(&USB2AX_CDC_Interface);
                    if (rxbyte[PACKET_INSTRUCTION] == AX_CMD_SYNC_READ){
                        ax_state = AX_GET_PARAMETERS;
                        ax_checksum =  rxbyte[PACKET_ID] + AX_CMD_SYNC_READ + rxbyte[PACKET_LENGTH];
                        receive_timer = 0;
                    } else if(rxbyte[PACKET_ID] == AX_ID_DEVICE){ 
				        if (rxbyte[PACKET_INSTRUCTION] == AX_CMD_PING){
					        ax_state = AX_SEARCH_PING;
					        receive_timer = 0;
				        } else if (rxbyte[PACKET_INSTRUCTION] == AX_CMD_RESET){
                            ax_state = AX_SEARCH_RESET;
                            LEDs_TurnOnLEDs(LEDS_LED2);
                            receive_timer = 0;
                        } else if (rxbyte[PACKET_INSTRUCTION] == AX_CMD_BOOTLOAD){
                            ax_state = AX_SEARCH_BOOTLOAD;
                            receive_timer = 0;
                        } else if (rxbyte[PACKET_INSTRUCTION] == AX_CMD_READ_DATA) {
				            ax_state = AX_GET_PARAMETERS;
                            ax_checksum = AX_ID_DEVICE + AX_CMD_READ_DATA + rxbyte[PACKET_LENGTH];
						    receive_timer = 0;
                        } else if (rxbyte[PACKET_INSTRUCTION] == AX_CMD_WRITE_DATA) {
                            ax_state = AX_GET_PARAMETERS;
                            ax_checksum = AX_ID_DEVICE + AX_CMD_WRITE_DATA + rxbyte[PACKET_LENGTH];
						    receive_timer = 0;
						} else {
                            cleanup_input_parser();
                        }
				    } else { 					
                        cleanup_input_parser();
                    }
                    break;
                            
                case AX_SEARCH_RESET:
                    rxbyte[5] = CDC_Device_ReceiveByte(&USB2AX_CDC_Interface);
                    if (((AX_ID_DEVICE + 2 + AX_CMD_RESET + rxbyte[5]) % 256) == 255){
                        LEDs_SetAllLEDs(LEDMASK_USB_NOTREADY);
                        eeprom_clear();
                        Jump_To_Reset(false);
                    } else {
                        cleanup_input_parser();
                    }
                    break;
                        
                case AX_SEARCH_BOOTLOAD:
                    rxbyte[5] = CDC_Device_ReceiveByte(&USB2AX_CDC_Interface);
                    if (((AX_ID_DEVICE + 2 + AX_CMD_BOOTLOAD + rxbyte[5]) % 256) == 255){
                        LEDs_TurnOffLEDs(LEDS_LED2);
                        LEDs_SetAllLEDs(LEDMASK_USB_NOTREADY);
                        Jump_To_Reset(true);
                    } else {
                        cleanup_input_parser();
                    }
                    break;
				
				case AX_SEARCH_PING:
					rxbyte[5] = CDC_Device_ReceiveByte(&USB2AX_CDC_Interface);
					if (((AX_ID_DEVICE + 2 + AX_CMD_PING + rxbyte[5]) % 256) == 255){
						axStatusPacket(AX_ERROR_NONE, NULL, 0);
						ax_state = AX_SEARCH_FIRST_FF;
                    } else {
					    cleanup_input_parser();
					}
					break;
				
                case AX_GET_PARAMETERS:
                    rxbyte[rxbyte_count] = CDC_Device_ReceiveByte(&USB2AX_CDC_Interface);
                    ax_checksum += rxbyte[rxbyte_count] ;
					rxbyte_count++;
                    receive_timer = 0;
                    if(rxbyte_count >= (rxbyte[PACKET_LENGTH] + 4)){ // we have read all the data for the packet
                        if((ax_checksum%256) != 255){  // ignore message if checksum is bad
                            cleanup_input_parser();
                        } else {
						    if (rxbyte[PACKET_INSTRUCTION] == AX_CMD_SYNC_READ){
                                uint8_t nb_servos_to_read = rxbyte[PACKET_LENGTH] - 4;
                                uint8_t packet_overhead = 6;
                                if( (rxbyte[SYNC_READ_LENGTH] == 0)
                                    || (rxbyte[SYNC_READ_LENGTH] > AX_BUFFER_SIZE - packet_overhead) // the return packets from the servos must fit the return buffer
                                    || ( (int16_t)rxbyte[SYNC_READ_LENGTH] * nb_servos_to_read > AX_MAX_RETURN_PACKET_SIZE - packet_overhead )){ // and the return packet to the host must not be bigger either
                                    axStatusPacket(AX_ERROR_RANGE, NULL, 0);
                                } else {
                                    sync_read(&rxbyte[SYNC_READ_START_ADDR], rxbyte[PACKET_LENGTH] - 2);
								}									
                            } else if (rxbyte[PACKET_INSTRUCTION] == AX_CMD_READ_DATA) {
						        local_read(rxbyte[5], rxbyte[6]);
                            } else if(rxbyte[PACKET_INSTRUCTION] == AX_CMD_WRITE_DATA){
                                local_write(rxbyte[5], &rxbyte[6], rxbyte[PACKET_LENGTH] - 3);
                            }
						    ax_state = AX_SEARCH_FIRST_FF;													
                        }
                    }
                    break;
                        
                    case AX_PASS_TO_SERVOS:
                        setTX();
                        serial_write(CDC_Device_ReceiveByte(&USB2AX_CDC_Interface));
                        rxbyte_count++;
                        receive_timer = 0;
                        if(rxbyte_count >= (rxbyte[PACKET_LENGTH] + 4)){ // we have read all the data for the packet // we have let the right number of bytes pass
                            ax_state = AX_SEARCH_FIRST_FF;
                        }
                        break;

                default:
                    break;
            }
        }
	}

	// Timeout on state machine while waiting on further USB data
    if(ax_state != AX_SEARCH_FIRST_FF){
        if (receive_timer > regs[ADDR_RECEIVE_TIMEOUT]){
            pass_bytes(rxbyte_count);
            ax_state = AX_SEARCH_FIRST_FF;
		}
    }

    if( bit_is_set(UCSR1B, TXEN1) ){ // if some data has been sent, revert to RX
        setRX();
    }
}

void pass_bytes(uint8_t nb_bytes){
    if(nb_bytes){
        setTX();
    }
    for (uint8_t i = 0; i < nb_bytes; i++){
        serial_write(rxbyte[i]);
    }
}


void setRX(void) {
	loop_until_bit_is_set( UCSR1A, TXC1 ); // wait until last byte has been sent (it will set USART Transmit Complete flag)
	
#if USE_RS485
    bitClear(PORTB, 1);
#endif
    
    // enable RX and RX interrupt, disable TX and all TX interrupt
    UCSR1B = ((1 << RXCIE1) | (1 << RXEN1));
}

inline void setTX(void) {
    
#if USE_RS485
    bitSet(PORTB, 1);
#endif
    
    // enable TX, disable RX and all RX interrupt
    UCSR1B = (1 << TXEN1);
}


void init_serial(long baud){
    UCSR1B = 0; // disable USART emitter and receiver, as well as all relative interrupts 
		// (Must turn off USART before reconfiguring it, otherwise incorrect operation may occur)
    UCSR1A = 0; // no frequency doubling, disable Multi-processor communication mode
    UCSR1C = (1<<UCSZ11) | (1<<UCSZ10); // Asynchronous USART, no parity, 1 bit stop, 8-bit (aka 8N1)
	
	
    // we want the actual baud rate to be as close as possible to the theoretical baud rate,
    // and at the same time we want to avoid using frequency doubling if possible, since it
    // cuts by half the number of sample the receiver will use, and makes it more vulnerable
    // to baud rate and clock inaccuracy.
    int32_t ubbr = SERIAL_UBBRVAL(baud);
    int32_t br = F_CPU /(16UL*(ubbr+1));

    int32_t ubbr2x = SERIAL_2X_UBBRVAL(baud);
    int32_t br2x = F_CPU /(8UL*(ubbr2x+1));

    if ( max(baud,br) - min(baud,br) <= max(baud,br2x) - min(baud,br2x) ){
        UBRR1 = ubbr; // set UART baud rate
    } else {
        UBRR1 = ubbr2x;
        bitSet(UCSR1A, U2X1);
    }
    // Another way to put it: if br and br2x are equal, choose the one with the highest stability (without U2X),
    // else choose the closest to the mark (and it will necessarily be the one with U2X).

    // enable RX and RX interrupt, disable TX and all TX interrupt
    UCSR1B = ((1 << RXCIE1) | (1 << RXEN1));
}


// Sends data directly out of serial port
void serial_write(uint8_t data){
    loop_until_bit_is_set(UCSR1A, UDRE1); //wait until the TX data registry can accept new data
    
    // Load the next byte from the USART transmit buffer into the USART
    UDR1 = data;            // transmit data
    bitSet(UCSR1A, TXC1);   // clear USART Transmit Complete flag
}


/** ISR to manage the reception of data from the serial port, placing received bytes into a buffer
 *  for later transmission to the host.
 */
ISR(USART1_RX_vect, ISR_BLOCK){
    //up1;
    uint8_t ReceivedByte = UDR1;
	if ( passthrough_mode == AX_PASSTHROUGH ){
		cdc_send_byte(ReceivedByte);
	} else {
		if (local_rx_buffer_count < AX_BUFFER_SIZE){
			local_rx_buffer[local_rx_buffer_count++] = ReceivedByte;
		}
		usart_timer = 0;
	}
    //dw1;
}

// global timer
ISR(TIMER0_COMPA_vect, ISR_BLOCK){
	receive_timer++;
    send_timer++;
	usart_timer++;
}


/** Configures the board hardware and chip peripherals. */
void setup_hardware(void){
    /* Disable watchdog if enabled by bootloader/fuses */
    MCUSR &= ~(1 << WDRF);
    wdt_disable();

    /* Disable clock division */
    clock_prescale_set(clock_div_1);

    /* Hardware Initialization */
    LEDs_Init();
    USB_Init();

#if USE_RS485
    // RS485 driver
    bitSet(DDRB, 1);
    bitClear(PORTB, 1);
#endif

    // Start the global timer 
    TCCR0A = (1 << WGM01); // CTC mode
    TCCR0B = 1 << CS01; // clock/8 pre-scaler
    OCR0A = 0x27;  // ticks every 20us
	TIMSK0 |= (1 << OCIE0A);  // enable Timer Compare A interrupt
}


/** Event handler for the library USB Connection event. */
void EVENT_USB_Device_Connect(void){
    LEDs_SetAllLEDs(LEDMASK_USB_ENUMERATING);
}

/** Event handler for the library USB Disconnection event. */
void EVENT_USB_Device_Disconnect(void){
    LEDs_SetAllLEDs(LEDMASK_USB_NOTREADY);
}

/** Event handler for the library USB Configuration Changed event. */
void EVENT_USB_Device_ConfigurationChanged(void){
    bool ConfigSuccess = true;

    ConfigSuccess &= CDC_Device_ConfigureEndpoints(&USB2AX_CDC_Interface);

    LEDs_SetAllLEDs(ConfigSuccess ? LEDMASK_USB_READY : LEDMASK_USB_ERROR);
}

/** Event handler for the library USB Control Request reception event. */
void EVENT_USB_Device_ControlRequest(void){
    CDC_Device_ProcessControlRequest(&USB2AX_CDC_Interface);
}

/** Event handler for the CDC Class driver Line Encoding Changed event.
 *
 *  \param[in] CDCInterfaceInfo  Pointer to the CDC class interface configuration structure being referenced
 */
void EVENT_CDC_Device_LineEncodingChanged(USB_ClassInfo_CDC_Device_t* const CDCInterfaceInfo){
    // Set the baud rate, ignore the rest of the configuration (parity, char format, number of bits in a byte) since the servos only understand 8N1

    init_serial(CDCInterfaceInfo->State.LineEncoding.BaudRateBPS);
    
    // If the baudrate is at this special (and unlikely) value, it means that we want to trigger the bootloader
    if (CDCInterfaceInfo->State.LineEncoding.BaudRateBPS == 1200){
        needs_bootload = true;
    }
}



// *********************  Soft reset/bootloader functionality *******************************************
// The bootloader can be ran by opening the serial port at 1200bps. Upon closing it, the reset process will be initiated
// and two seconds later, the board will re-enumerate as a DFU bootloader.


// adapted from http://www.avrfreaks.net/index.php?name=PNphpBB2&file=viewtopic&p=1008792#1008792
void EVENT_CDC_Device_ControLineStateChanged(USB_ClassInfo_CDC_Device_t* const CDCInterfaceInfo){
    static bool PreviousDTRState = false;
    bool        CurrentDTRState  = (CDCInterfaceInfo->State.ControlLineStates.HostToDevice & CDC_CONTROL_LINE_OUT_DTR);

    /* Check how the DTR line has been asserted */
    if (PreviousDTRState && !(CurrentDTRState) ){
        // PreviousDTRState == True AND CurrentDTRState == False
        // Host application has Disconnected from the COM port
        
        if (needs_bootload){
            Jump_To_Reset(true);
        }
    }
    PreviousDTRState = CurrentDTRState;
}
// ******************************************************************************************************
