Xevel/usb2ax/(commit log)

2014-02-23 Import of the data from paranoidstudio repo - with slight cleanup of the folder tree.
    [usb2ax_mini.brd, usb2ax_mini.sch, usb2ax_v1.brd, usb2ax_v1.sch, usb2ax_v3.0.brd, usb2ax_v3.0.sch, usb2ax_v3.1.brd, usb2ax_v3.1.sch]
2014-02-25 Removed a mod that was for a version interfacing with RS485 servos using a MAX485. It will be reborn in a branch.
2014-03-07 Updated link to the (fixed) code of the reboot/bootload trick
    [reset.c]
2014-12-29 Added USB2AX v4 first hardware rev. WIP.
    [usb2ax_v4.0.brd, usb2ax_v4.0.sch]
2014-12-30 v4 hardware: sch probably done, tentative routing.
    [usb2ax_v4.0.brd, usb2ax_v4.0.sch]
2014-12-30 v4 hardware probably done.
    [usb2ax_v4.0.brd, usb2ax_v4.0.sch]
2015-01-17 [Firmware] fixed crash upon reading from the USB2AX before talking to servos.
    [AX.c, USB2AX.c]
2015-01-18 [firmware] fixed perf penalty for packets >8bytes long, added debug functionalities.
    [USB2AX.c, USB2AX.h, debug.h]
2015-01-19 [firmware] added write_data command and dynamic Dynamixel table (the values of which are currently not used by the rest of the program...)
2015-01-20 [firmware] Added eeprom saving and recovery of registers (and return to default with "reset" command). Registers still not in use though.
    [AX.c, AX.h, USB2AX.c, eeprom.c, eeprom.h]
2015-02-04 Now there is no retention of the bytes coming from the host: every command is transmitted directly to the bus, even Sync_read. The servos should be able to ignore them anyway, as they are all valid d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
2016-04-06 Upgraded to v3.2b : changed R3 from 150 to 47ohms for stronger line drive
    [usb2ax_v3.2.brd, usb2ax_v3.2.sch]
2017-06-29 [firmware] v05RC0 * Increased ToUSB_Buffer_Data size from 128 to 254. This seems to have resolved the issue where a read on a device with a long table (176 bytes) would cause the board to randomly lo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
    * Anticipated the moment when interruptions are disabled in RingBuffer_Insert and RingBuffer_Remove.
    It is unclear if this is essential: I tested the device without this fix and it also worked with just the increased buffer size. However, this seems like a potential race condition because manipulation of the buffer structures was not completely prot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
    [USB2AX.c]
2017-07-27 Reverted the changes applied to ringbuffer as they were not necessary and thus were over-protective.
    [USB2AX.c]
2017-07-27 Fix for the spurious error messages returned to the host by the USB2AX when DXL2.0 packets are issued. Thanks to Tho- Updated binary to RC1.
    [USB2AX.c]
